AlexVolkov1987/UltiSteel_electronics/README.md

# UltiSteel_electronics
Electronics update for Ulti Steel 3D printer

------

:warning: Автор не несет ответственности за неправильную сборку, выбор комплектующих и любую порчу имущества и здоровья, вызванную эксплуатацией описываемых плат.
