AlexVolkov1987/UltiSteel_electronics/UlTi_head_connector/pdf/Connection to skr.pdf

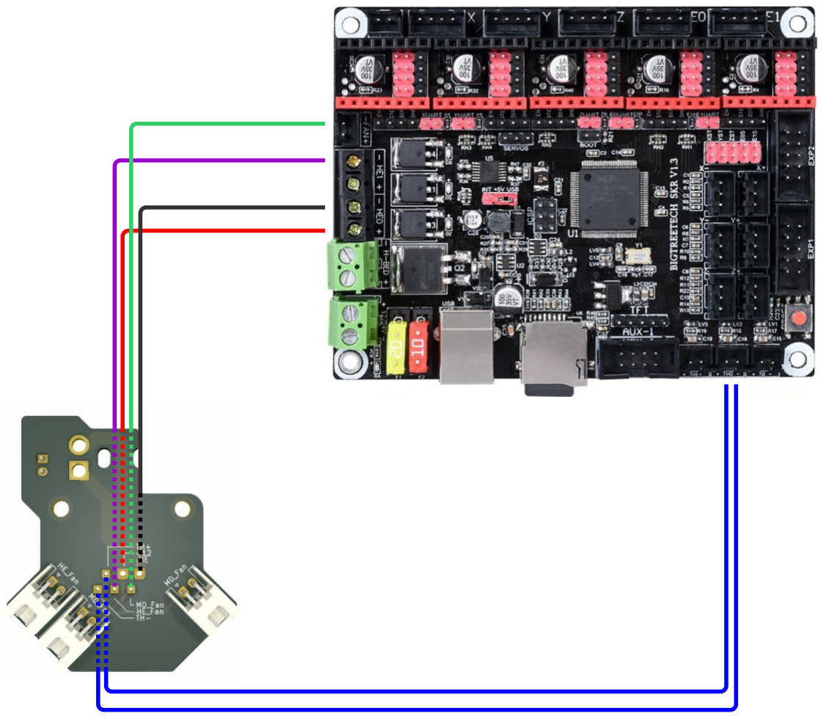
[picture p1: figure]

Провода +12 и HE 0.75мм (можно взять провода от нагревателя хотэнда)
Остальные провода сечением около 0.2мм

Все провода подключаются к плате головы со стороны разъемов хотэнда и термистора

С лицевой стороны платы:
HE_Fan на плате - разъем для кулера ХОТЭНДА
MD_Fan - разъемы для кулеров обдува МОДЕЛИ
В этих разъемах треугольник указывает на красный провод кулера.

С обратной стороны платы:
Heater - нагреватель
Thermistor - термистор

Термистор и нагреватель не имеют полярности и подключаются к пинам своих разъемов в любом порядке
