AlexVolkov1987/UltiSteel_electronics/UlTi_driver_ext_board/BOM.xlsx

REF | Value | Analog | Comment | Count
C1-C3 | 10uF 50V |  | Any 1206 smd ceramic 50V | 3
Q1-Q3 | IRLML6344 | PL4009 | TTL mosfet | 3
R1-R3 | 47 |  | 0603 smd res | 3
R4, R5 | 10k |  | 0603 smd res | 3
J1-J6 |  | PLS-40 | Split to 2 pieces (8 pins on each) | 1
XT2-XT4 | B2B-XH-A |  | JST-XH 2.5 series 2 pins | 3
