AlexVolkov1987/UltiSteel_electronics/UlTi_head_connector/BOM.xlsx

REF | Value | Analog | Comment | Count
Heater | AMASS XT30U-F |  |  | 1
HE_Fan, MD_Fan | JST XH S2B-XH-A |  |  | 3
Thermistor | JST XH B2B-XH-A |  |  | 1
