AlexVolkov1987/UltiSteel_electronics/UlTi_head_connector/isolator.dxf

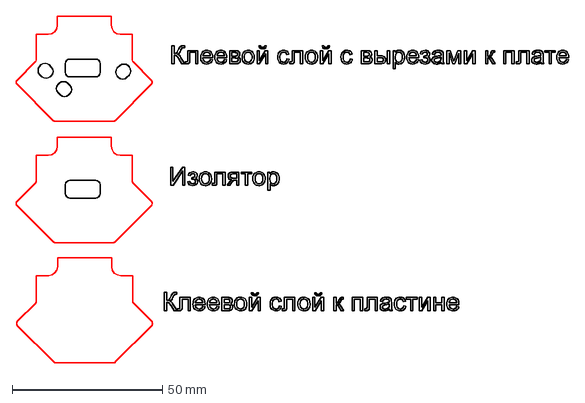
[picture p2: CAD file, 2021-06-25]
UlTi_head_connector/isolator.dxf
183.8 x 115.3 mm
