AlexVolkov1987/UltiSteel_electronics/UlTi_head_connector/прокладка.STL

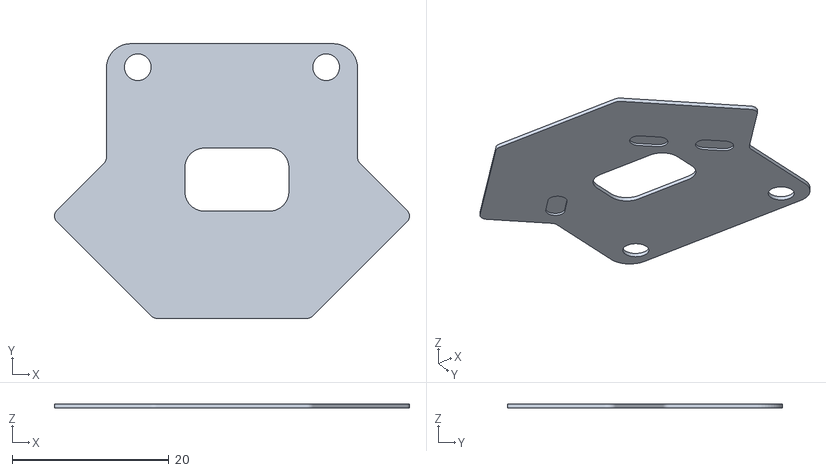
[picture p3: CAD file, 2021-06-25]
UlTi_head_connector/прокладка.STL
45.2 x 35.0 x 0.5
