AlexVolkov1987/UltiSteel_electronics/UlTi_head_connector/board.dxf

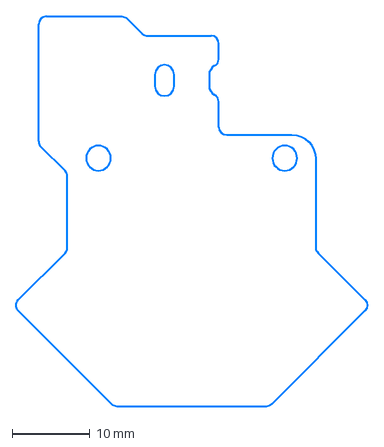
[picture p4: CAD file, 2021-01-16]
UlTi_head_connector/board.dxf
45.3 x 50.2 mm
