AlexVolkov1987/UltiSteel_electronics/Advanced_power_control/APC/PDF/TOP-assembly.pdf

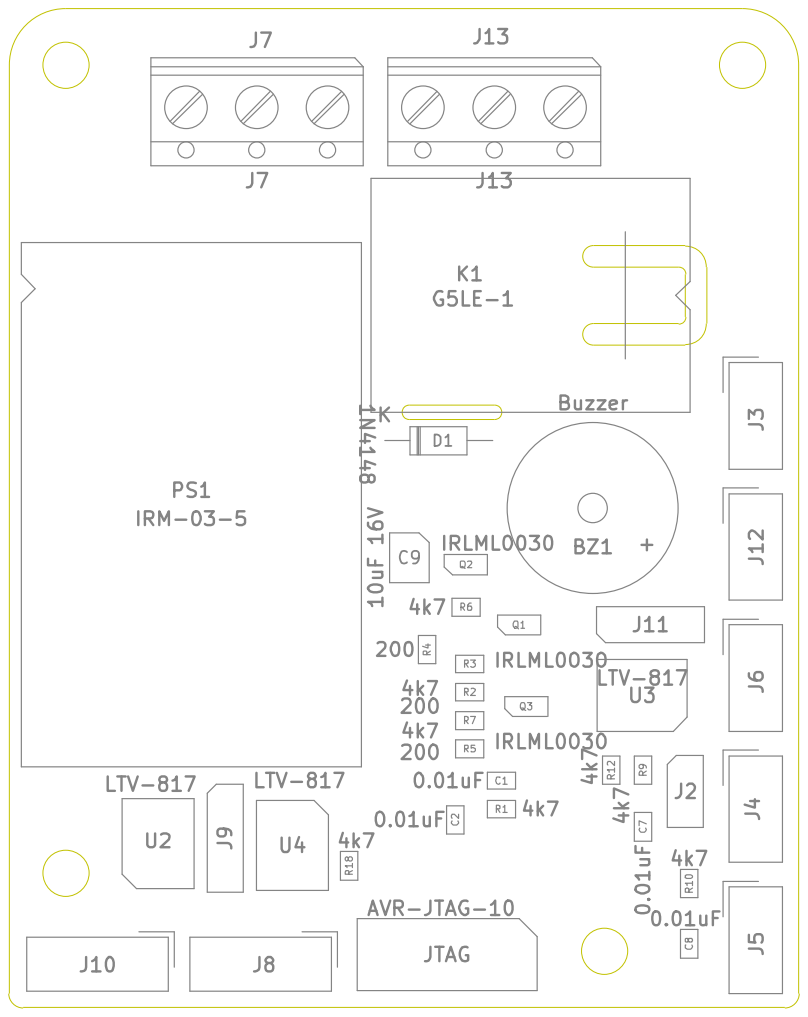
[picture p5: page 1]
