AlexVolkov1987/UltiSteel_electronics/Advanced_power_control/APC/PDF/BOTTOM-assembly.pdf

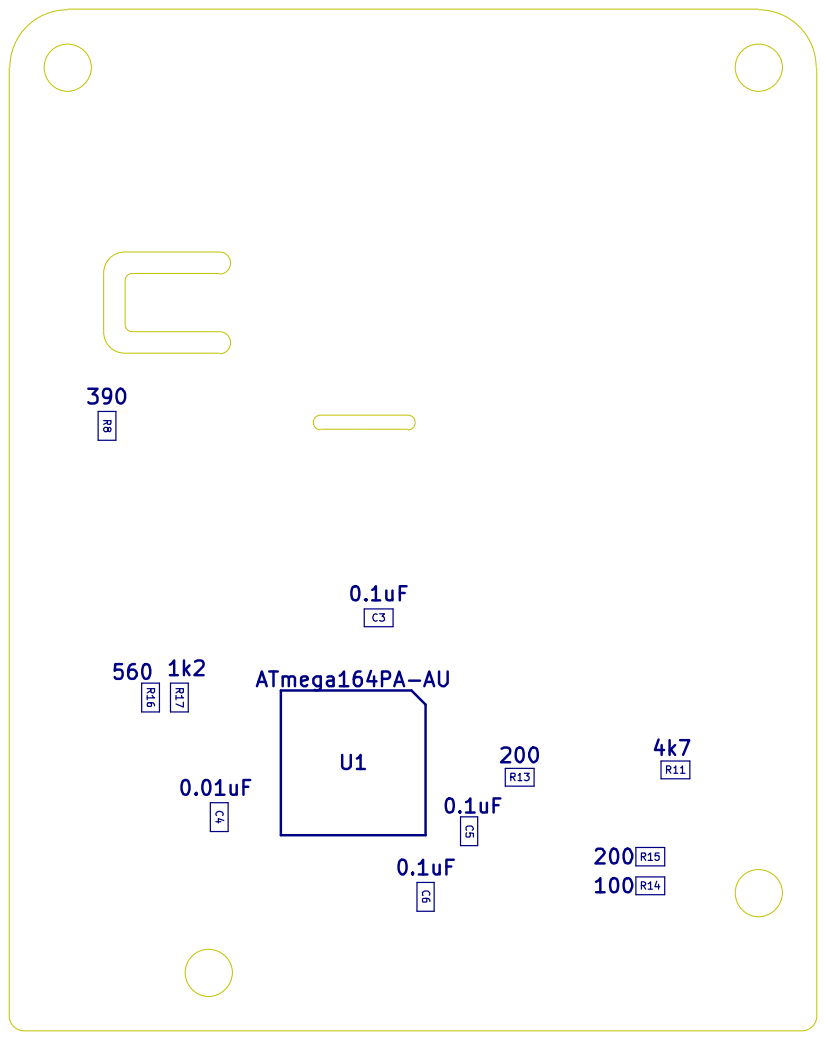
[picture p6: page 1]
