AlexVolkov1987/UltiSteel_electronics/UlTi_driver_ext_board/pdf/UlTi_driver_ext_board.pdf

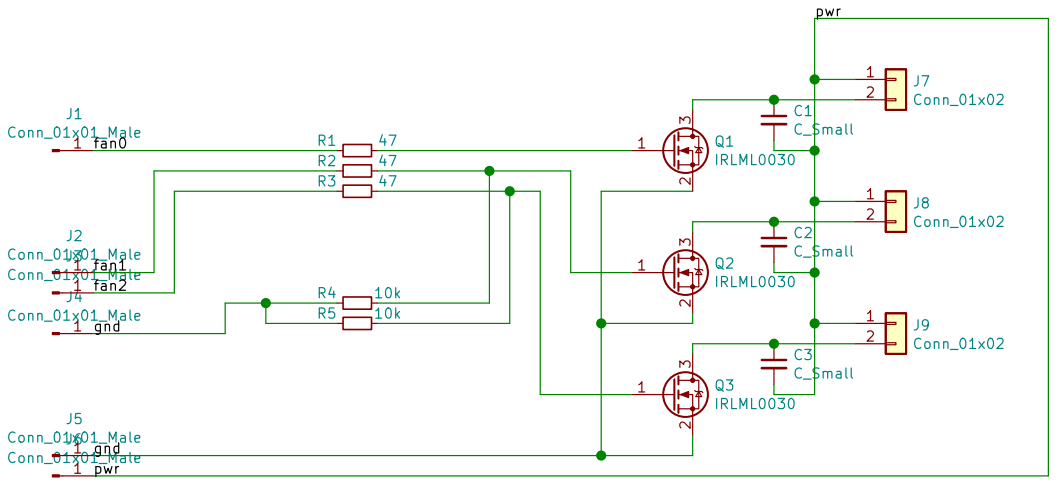
[picture p7: page 1]
