AlexVolkov1987/UltiSteel_electronics/UlTi_head_connector/pdf/UlTi_head_connector.pdf

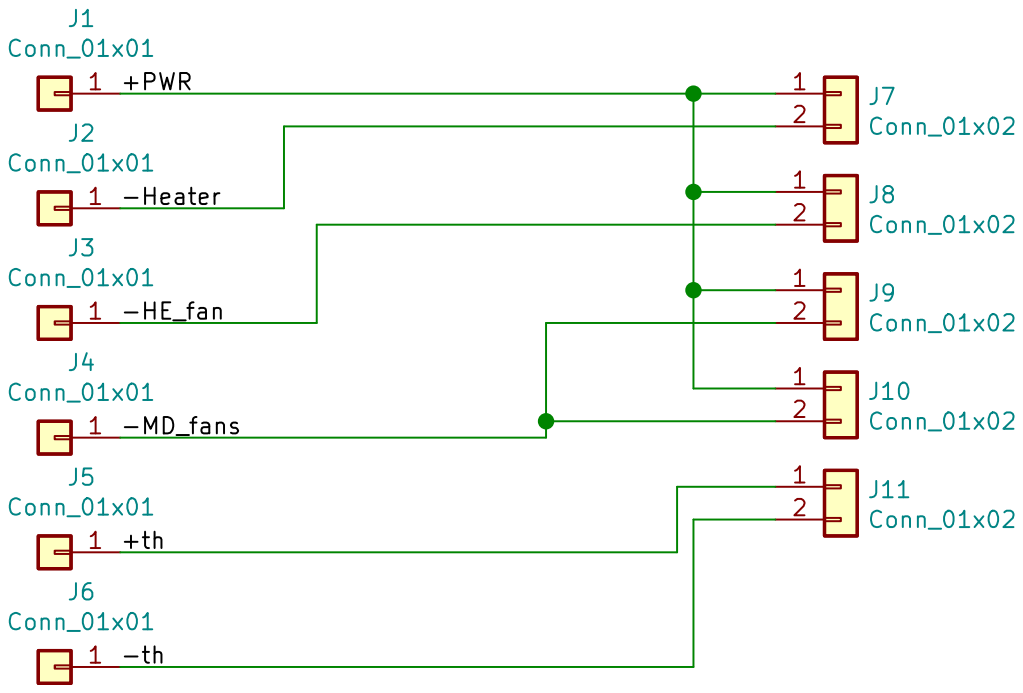
[picture p8: page 1]
