AlexVolkov1987/UltiSteel_electronics/Advanced_power_control/APC/APC.kicad_pcb

## KiCad design Advanced_power_control/APC/APC.kicad_pcb (2021-05-04)

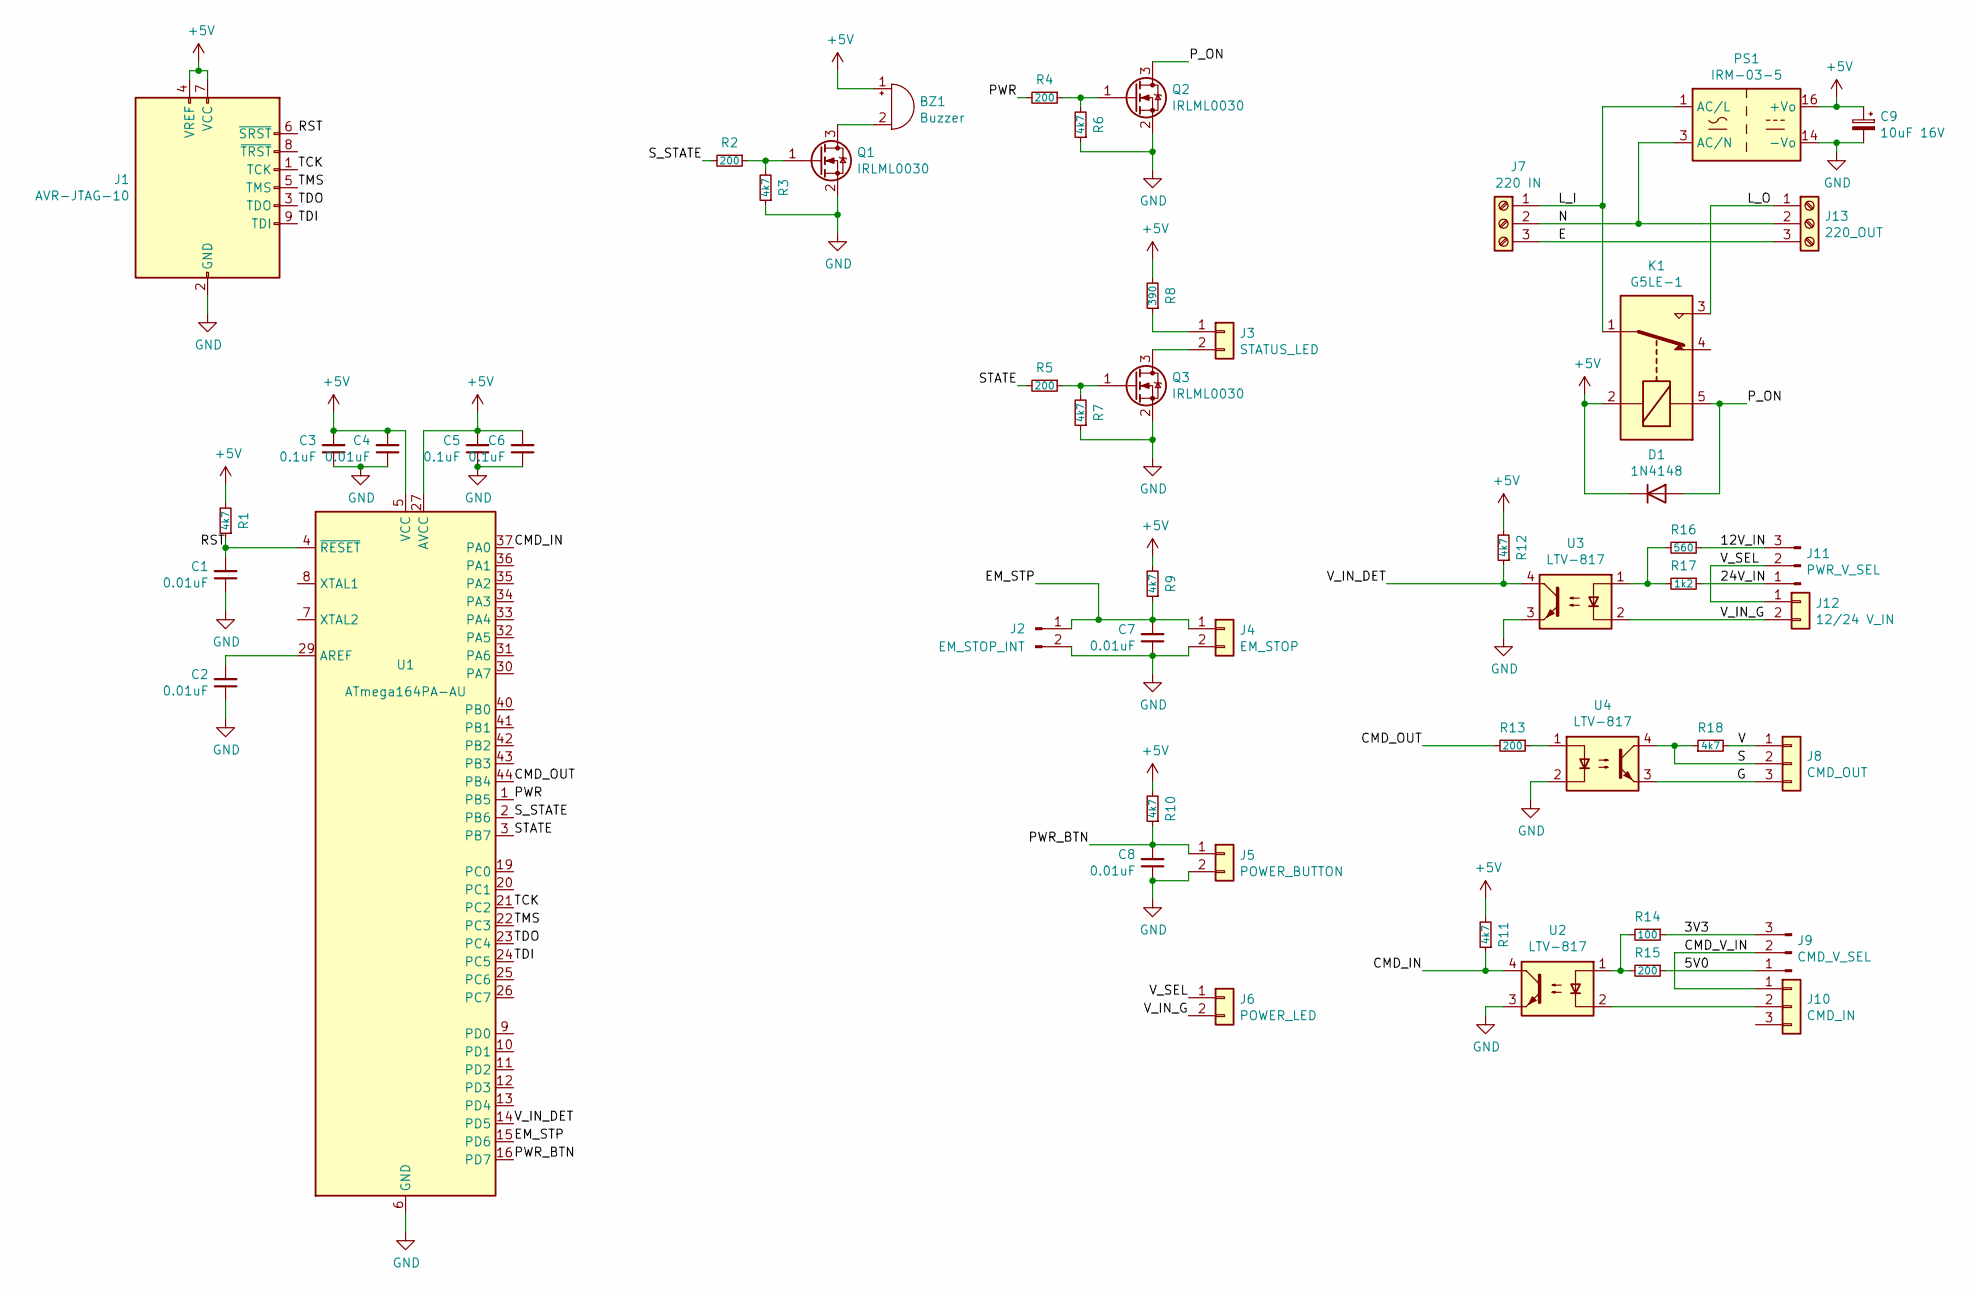
[picture p9: schematic APC.sch]

Parts:
BZ1: Buzzer; Buzzer_12x9.5RM7.6
C1, C2, C4, C7, C8: 0.01uF; C_0805_2012Metric_Pad1.15x1.40mm_HandSolder
C3, C5, C6: 0.1uF; C_0805_2012Metric_Pad1.15x1.40mm_HandSolder
C9: 10uF 16V; CP_EIA-3528-21_Kemet-B_Pad1.50x2.35mm_HandSolder
D1: 1N4148; D_DO-35_SOD27_P7.62mm_Horizontal
J1: AVR-JTAG-10; PinHeader_2x05_P2.54mm_Vertical
J2: EM_STOP_INT; PinHeader_1x02_P2.54mm_Vertical
J3: STATUS_LED; JST_EH_B2B-EH-A_1x02_P2.50mm_Vertical
J4: EM_STOP; JST_EH_B2B-EH-A_1x02_P2.50mm_Vertical
J5: POWER_BUTTON; JST_EH_B2B-EH-A_1x02_P2.50mm_Vertical
J6: POWER_LED; JST_EH_B2B-EH-A_1x02_P2.50mm_Vertical
J7: 220 IN; TerminalBlock_RND_205-00013_1x03_P5.00mm_Horizontal
J8: CMD_OUT; JST_EH_B3B-EH-A_1x03_P2.50mm_Vertical
J9: CMD_V_SEL; PinHeader_1x03_P2.54mm_Vertical
J10: CMD_IN; JST_EH_B3B-EH-A_1x03_P2.50mm_Vertical
J11: PWR_V_SEL; PinHeader_1x03_P2.54mm_Vertical
J12: 12/24 V_IN; JST_EH_B2B-EH-A_1x02_P2.50mm_Vertical
J13: 220_OUT; TerminalBlock_RND_205-00013_1x03_P5.00mm_Horizontal
K1: G5LE-1; Relay_SPDT_Omron-G5LE-1
PS1: IRM-03-5; Converter_ACDC_MeanWell_IRM-03-xx_THT
Q1, Q2, Q3: IRLML0030; SOT-23
R1, R3, R6, R7, R9, R10, R11, R12, R18: 4k7; R_0805_2012Metric_Pad1.20x1.40mm_HandSolder
R2, R4, R5, R13, R15: 200; R_0805_2012Metric_Pad1.20x1.40mm_HandSolder
R8: 390; R_0805_2012Metric_Pad1.20x1.40mm_HandSolder
R14: 100; R_0805_2012Metric_Pad1.20x1.40mm_HandSolder
R16: 560; R_0805_2012Metric_Pad1.20x1.40mm_HandSolder
R17: 1k2; R_0805_2012Metric_Pad1.20x1.40mm_HandSolder
U1: ATmega164PA-AU; TQFP-44_10x10mm_P0.8mm
U2, U3, U4: LTV-817; DIP-4_W7.62mm

Connections:
+5V: BZ1.1 (-), C3.2, C4.2, C5.2, C6.2, C9.1, D1.1 (K), J1.4 (VREF), J1.7 (VCC), K1.2, PS1.16 (+Vo), R1.2, R8.2, R9.2, R10.2, R11.2, R12.2, U1.5 (VCC), U1.17 (VCC), U1.27 (AVCC), U1.38 (VCC); also elsewhere on the board
/3V3: J9.3, R14.1
/5V0: J9.1, R15.1
/12V_IN: J11.3, R16.1
/24V_IN: J11.1, R17.1
/CMD_IN: R11.1, U1.37 (PA0), U2.4
/CMD_OUT: R13.2, U1.44 (PB4)
/CMD_V_IN: J9.2, J10.1
/E: J7.3, J13.3
/EM_STP: C7.2, J2.1, J4.1, R9.1, U1.15 (PD6)
/G: J8.3, U4.3
/L_I: J7.1, K1.1, PS1.1 (AC/L)
/L_O: J13.1, K1.3
/N: J7.2, J13.2, PS1.3 (AC/N)
/PWR: R4.2, U1.1 (PB5)
/PWR_BTN: C8.2, J5.1, R10.1, U1.16 (PD7)
/P_ON: D1.2 (A), K1.5, Q2.3 (D)
/RST: C1.2, J1.6 (~SRST), R1.1, U1.4 (~RESET); also elsewhere on the board
/S: J8.2, R18.1, U4.4
/STATE: R5.2, U1.3 (PB7)
/S_STATE: R2.2, U1.2 (PB6)
/TCK: J1.1 (TCK), U1.21 (PC2); also elsewhere on the board
/TDI: J1.9 (TDI), U1.24 (PC5); also elsewhere on the board
/TDO: J1.3 (TDO), U1.23 (PC4); also elsewhere on the board
/TMS: J1.5 (TMS), U1.22 (PC3); also elsewhere on the board
/V: J8.1, R18.2
/V_IN_DET: R12.1, U1.14 (PD5), U3.4
/V_IN_G: J6.2, J12.2, U3.2
/V_SEL: J6.1, J11.2, J12.1
GND: C1.1, C2.1, C3.1, C4.1, C5.1, C6.1, C7.1, C8.1, C9.2, J1.2 (GND), J1.10 (GND), J2.2, J4.2, J5.2, PS1.14 (-Vo), Q1.2 (S), Q2.2 (S), Q3.2 (S), R3.1, R6.1, R7.1, U1.6 (GND), U1.18 (GND), U1.28 (GND), U1.39 (GND), U2.3, U3.3, U4.2; also elsewhere on the board
unnamed: BZ1.2 (+), Q1.3 (D)
unnamed: C2.2, U1.29 (AREF)
unnamed: J3.1, R8.1
unnamed: J3.2, Q3.3 (D)
unnamed: J10.2, U2.2
unnamed: Q1.1 (G), R2.1, R3.2
unnamed: Q2.1 (G), R4.1, R6.2
unnamed: Q3.1 (G), R5.1, R7.2
unnamed: R13.1, U4.1
unnamed: R14.2, R15.2, U2.1
unnamed: R16.2, R17.2, U3.1

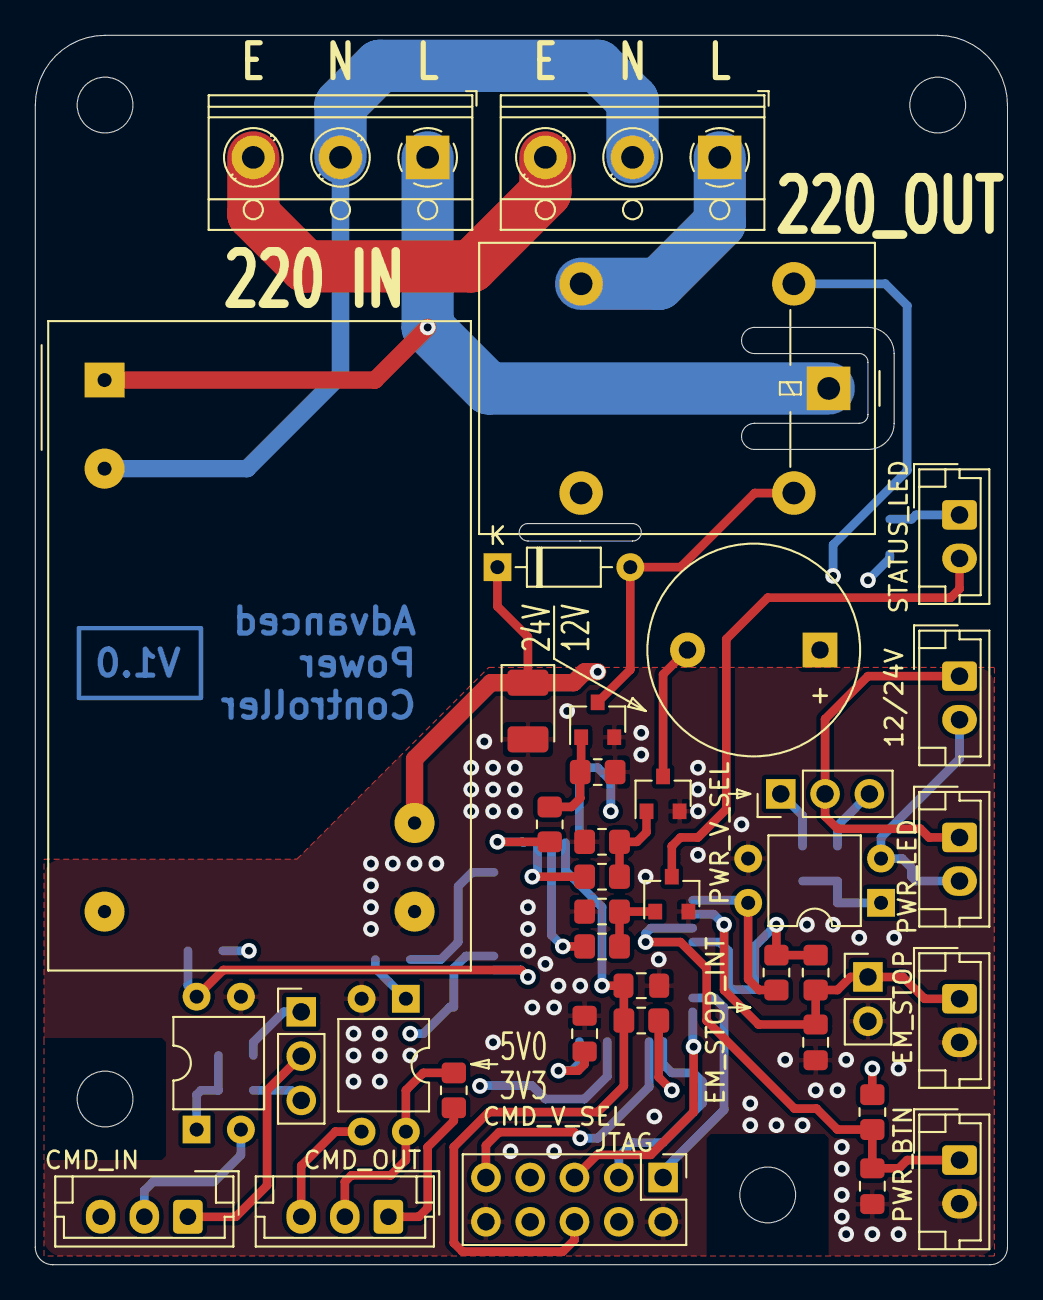
[picture p10: board APC.kicad_pcb from above]

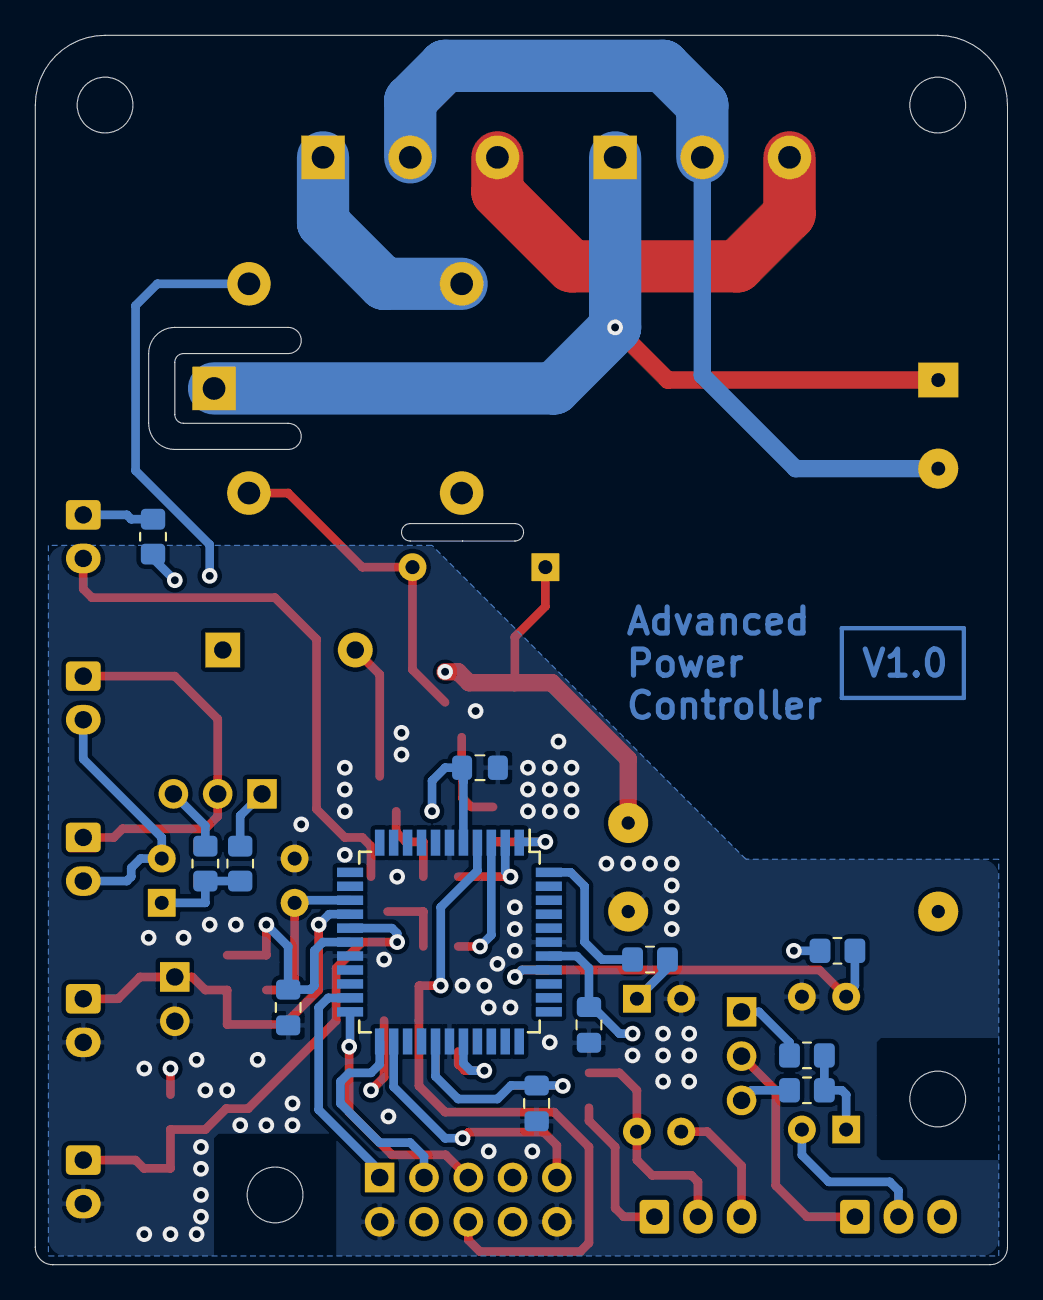
[picture p11: board APC.kicad_pcb from below]

Board: 4 copper layers, 55.8 x 70.5 mm, 51 parts (12 on the bottom side), 41 nets.

Other parts of the board:
JTAG: AVR-JTAG-10; PinHeader_2x05_P2.54mm_Vertical

Their connections:
+5V: JTAG.4, JTAG.7; also elsewhere on the board
/RST: JTAG.6; also elsewhere on the board
/TCK: JTAG.1; also elsewhere on the board
/TDI: JTAG.9; also elsewhere on the board
/TDO: JTAG.3; also elsewhere on the board
/TMS: JTAG.5; also elsewhere on the board
GND: JTAG.2, JTAG.10; also elsewhere on the board
