AlexVolkov1987/UltiSteel_electronics/Power_filter/Power_filter.kicad_pcb

## KiCad design Power_filter/Power_filter.kicad_pcb (2021-03-15)

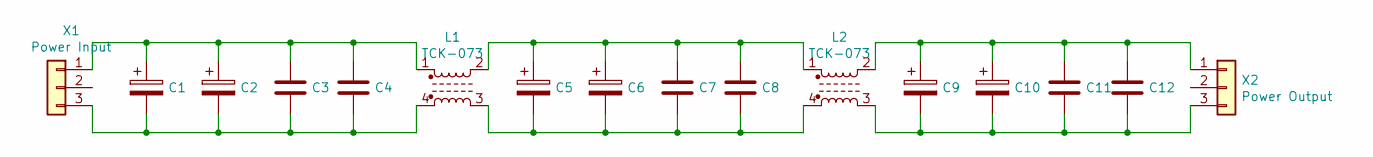
[picture p12: schematic Power_filter.sch]

Parts:
C1, C2, C5, C6, C9, C10: SH050M2200B7F-1636; CP_Radial_D16.0mm_P7.50mm
C3, C7, C11: RDER71H225K2K1H03B; C_Rect_L7.0mm_W3.5mm_P5.00mm
C4, C8, C12: RCER71H104K0M1H03A; C_Rect_L7.0mm_W2.5mm_P5.00mm
L1, L2: TCK-073; TRACO TCK-073
X1: Power Input; TerminalBlock_RND_205-00046_1x03_P5.00mm_Horizontal
X2: Power Output; TerminalBlock_RND_205-00046_1x03_P5.00mm_Horizontal

Connections:
unnamed: C1.1, C2.1, C3.1, C4.1, L1.1, X1.1
unnamed: C1.2, C2.2, C3.2, C4.2, L1.4, X1.3
unnamed: C5.1, C6.1, C7.1, C8.1, L1.2, L2.1
unnamed: C5.2, C6.2, C7.2, C8.2, L1.3, L2.4
unnamed: C9.1, C10.1, C11.1, C12.1, L2.2, X2.1
unnamed: C9.2, C10.2, C11.2, C12.2, L2.3, X2.3

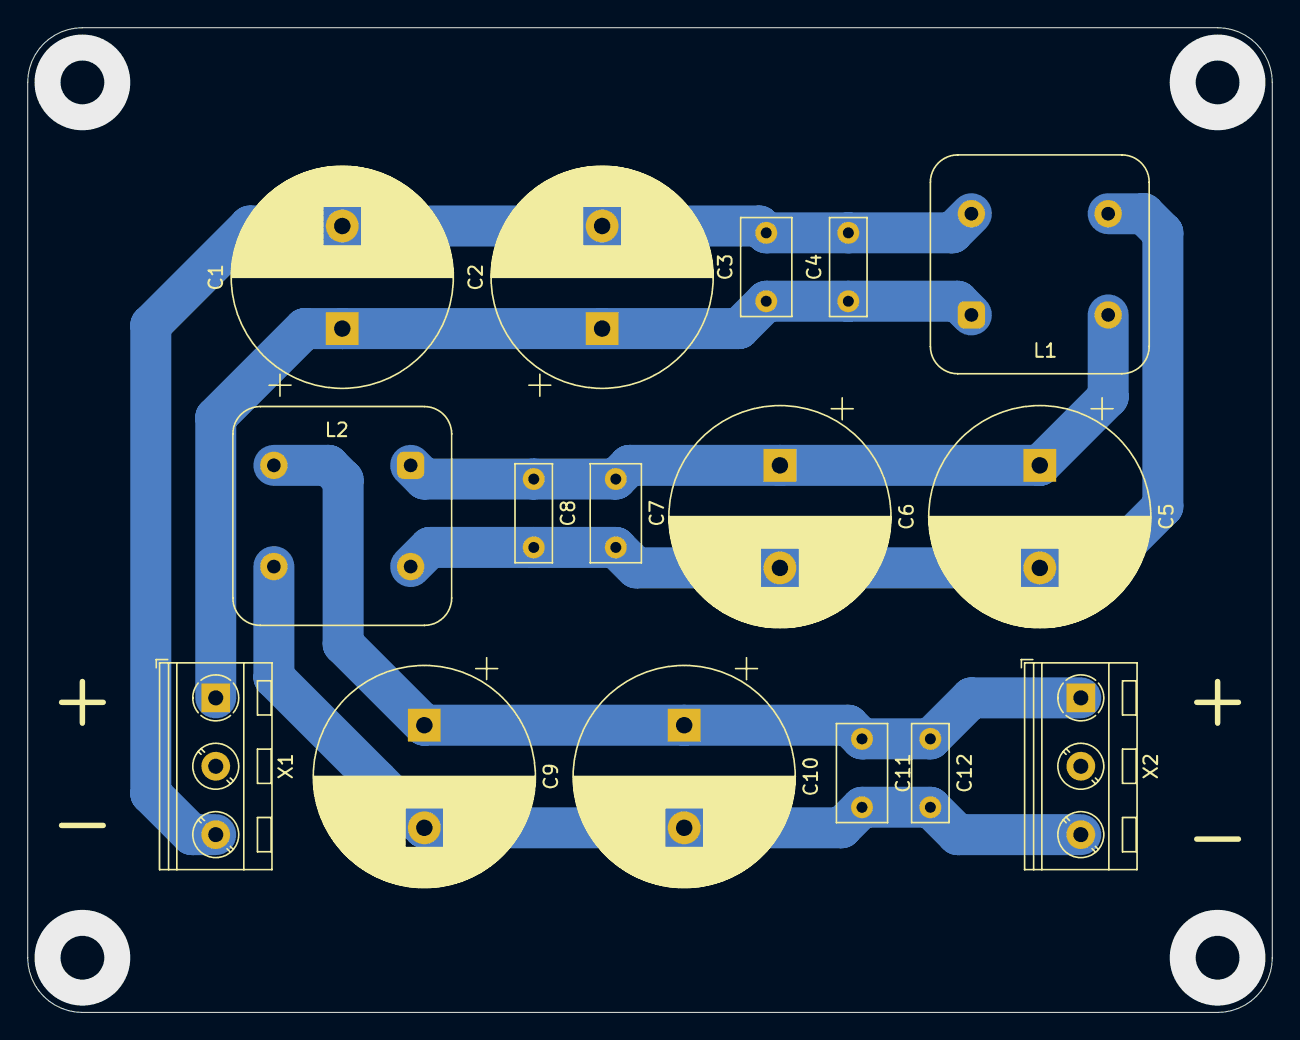
[picture p13: board Power_filter.kicad_pcb from above]

Board: 2 copper layers, 91.0 x 72.0 mm, 16 parts (0 on the bottom side), 6 nets.
