AlexVolkov1987/UltiSteel_electronics/UlTi_driver_ext_board/UlTi_driver_ext_board.kicad_pcb

## KiCad design UlTi_driver_ext_board/UlTi_driver_ext_board.kicad_pcb (2021-01-16)

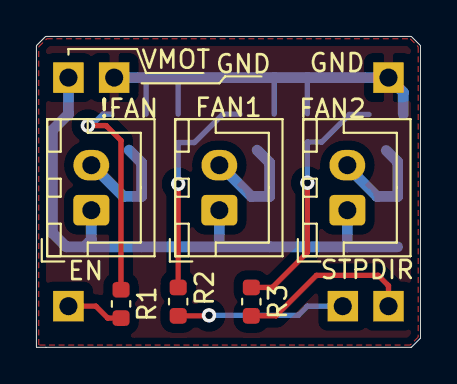
[picture p14: board UlTi_driver_ext_board.kicad_pcb from above]

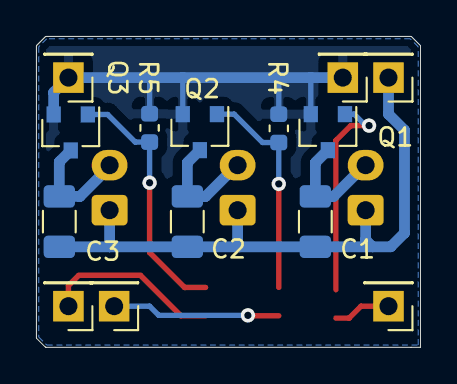
[picture p15: board UlTi_driver_ext_board.kicad_pcb from below]

Board: 2 copper layers, 21.3 x 17.3 mm, 20 parts (14 on the bottom side), 11 nets.

Parts:
!FAN: Conn_01x02; JST_XH_B2B-XH-A_1x02_P2.50mm_Vertical
C1, C2, C3: C_Small; C_1206_3216Metric
DIR: Conn_01x01_Male; PinHeader_1x01_P2.54mm_Vertical
EN: Conn_01x01_Male; PinHeader_1x01_P2.54mm_Vertical
FAN1, FAN2: Conn_01x02; JST_XH_B2B-XH-A_1x02_P2.50mm_Vertical
GND: Conn_01x01_Male; PinHeader_1x01_P2.54mm_Vertical
GND#2: Conn_01x01_Male; PinHeader_1x01_P2.54mm_Vertical
Q1, Q2, Q3: IRLML0030; SOT-23
R1, R2, R3: 47; R_0603_1608Metric
R4, R5: 10k; R_0603_1608Metric
STP: Conn_01x01_Male; PinHeader_1x01_P2.54mm_Vertical
VMOT: Conn_01x01_Male; PinHeader_1x01_P2.54mm_Vertical

Connections:
/fan0: EN.1, R1.2
/fan1: R2.2, STP.1
/fan2: DIR.1, R3.2
/gnd: GND.1, GND#2.1, Q1.2, Q2.2, Q3.2, R4.2, R5.2
/pwr: !FAN.1, C1.2, C2.2, C3.2, FAN1.1, FAN2.1, VMOT.1
unnamed: !FAN.2, C1.1, Q1.3
unnamed: C2.1, FAN1.2, Q2.3
unnamed: C3.1, FAN2.2, Q3.3
unnamed: Q1.1, R1.1
unnamed: Q2.1, R2.1, R4.1
unnamed: Q3.1, R3.1, R5.1
