AlexVolkov1987/UltiSteel_electronics/UlTi_head_connector/UlTi_head_connector.kicad_pcb

## KiCad design UlTi_head_connector/UlTi_head_connector.kicad_pcb (2021-01-16)

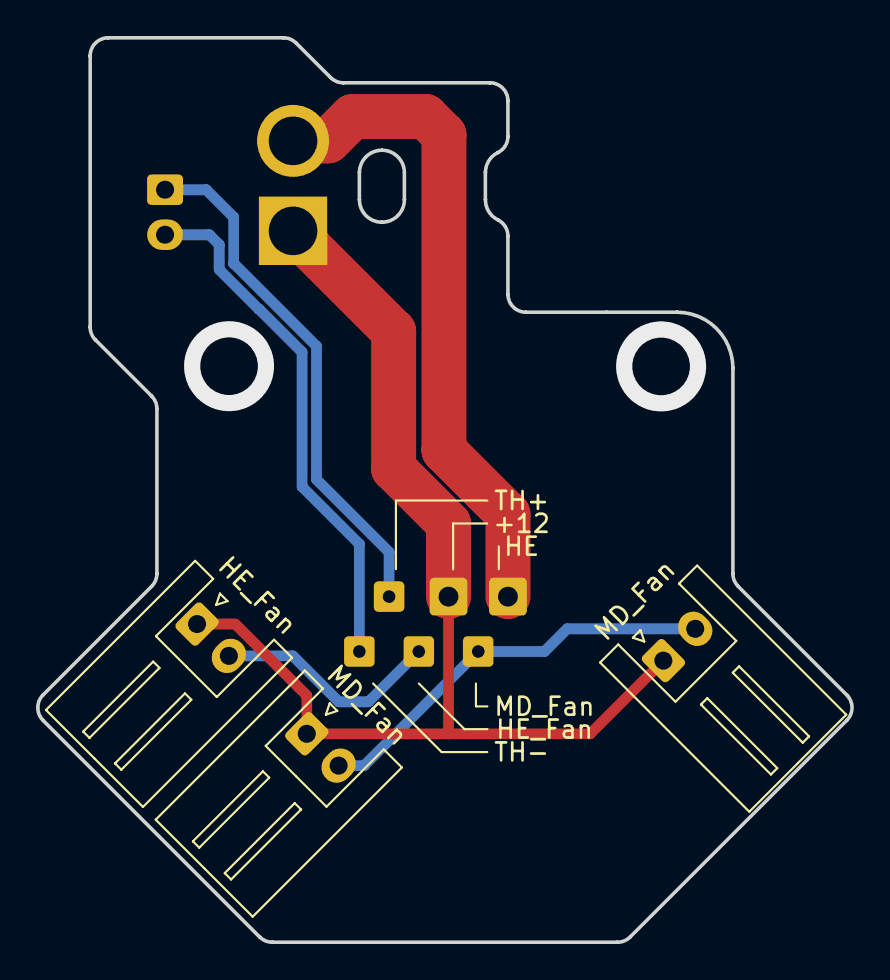
[picture p16: board UlTi_head_connector.kicad_pcb from above]

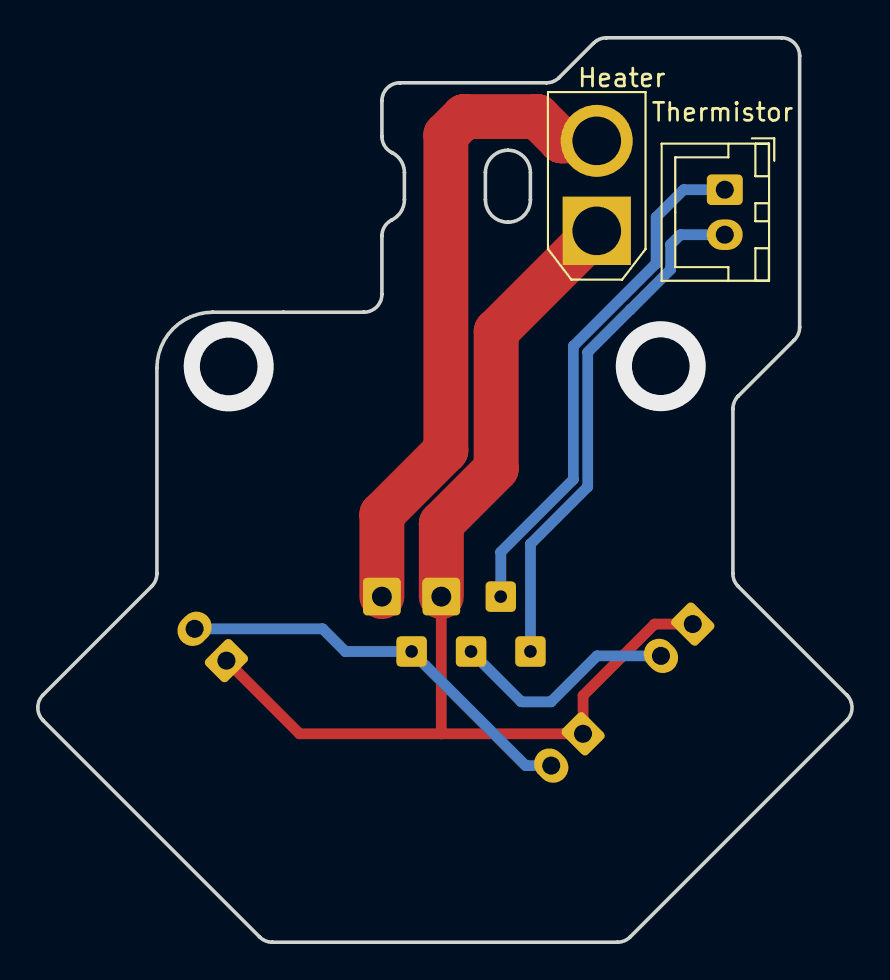
[picture p17: board UlTi_head_connector.kicad_pcb from below]

Board: 2 copper layers, 45.2 x 50.2 mm, 11 parts (2 on the bottom side), 6 nets.

Parts:
+12: Conn_01x01; SolderWire-0.5sqmm_1x01_D0.9mm_OD2.1mm
HE: Conn_01x01; SolderWire-0.5sqmm_1x01_D0.9mm_OD2.1mm
HE_Fan: Conn_01x02; JST_XH_S2B-XH-A_1x02_P2.50mm_Horizontal
HE_Fan#2: Conn_01x01; SolderWire-0.15sqmm_1x01_D0.5mm_OD1.5mm
Heater: Conn_01x02; AMASS_XT30U-F_1x02_P5.0mm_Vertical
MD_Fan: Conn_01x02; JST_XH_S2B-XH-A_1x02_P2.50mm_Horizontal
MD_Fan#2: Conn_01x02; JST_XH_S2B-XH-A_1x02_P2.50mm_Horizontal
MD_Fan#3: Conn_01x01; SolderWire-0.15sqmm_1x01_D0.5mm_OD1.5mm
TH+: Conn_01x01; SolderWire-0.15sqmm_1x01_D0.5mm_OD1.5mm
TH-: Conn_01x01; SolderWire-0.15sqmm_1x01_D0.5mm_OD1.5mm
Thermistor: Conn_01x02; JST_XH_B2B-XH-A_1x02_P2.50mm_Vertical

Connections:
/+PWR: +12.1, HE_Fan.1, Heater.1, MD_Fan.1, MD_Fan#2.1
/+th: TH+.1, Thermistor.1
/-HE_fan: HE_Fan.2, HE_Fan#2.1
/-Heater: HE.1, Heater.2
/-MD_fans: MD_Fan.2, MD_Fan#2.2, MD_Fan#3.1
/-th: TH-.1, Thermistor.2
