AlexVolkov1987/UltiSteel_electronics/(commit log)

2021-01-16 Initial Commit
    Добавлены все файлы проектов платы расширения и платы головы
    [BOM.xlsx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]
2021-03-15 add test power_filter
    [Power_filter.kicad_pcb, Power_filter.sch]
2021-03-17 add gerbers
    [Power_filter-B_Cu.gbr, Power_filter-B_Mask.gbr, Power_filter-B_SilkS.gbr, Power_filter-Edge_Cuts.gbr, Power_filter-F_Cu.gbr, Power_filter-F_Mask.gbr, Power_filter-F_SilkS.gbr, Power_filter-NPTH.drl]
2021-04-27 add APC
    [APC.kicad_pcb, APC.sch]
2021-04-28 init schematic
    [APC.sch]
2021-04-28 update schematic
    [APC.sch]
2021-04-28 add some schematic features
    [APC.sch]
2021-04-29 pcb routing
    [APC.kicad_pcb, APC.sch]
2021-04-29 update schematic and board
    [APC.kicad_pcb, APC.sch]
2021-04-30 minimize pcb size
    [APC.kicad_pcb, APC.sch]
2021-05-04 Update APC.kicad_pcb
    PreFinal correction
    [APC.kicad_pcb]
2021-05-04 Release 1.0
    Update pcb
    Add assembly pdf-files
    Add gerber files
    [APC-B_Cu.gbl, APC-B_Mask.gbs, APC-B_Paste.gbp, APC-B_SilkS.gbo, APC-Edge_Cuts.gm1, APC-F_Cu.gtl, APC-F_Mask.gts, APC-F_Paste.gtp]
2021-05-04 some changes
    Change vias size fo jlcpcb
    Add gerbers in zip archive
    [APC-B_Cu.gbl, APC-B_Mask.gbs, APC-B_Paste.gbp, APC-B_SilkS.gbo, APC-Edge_Cuts.gm1, APC-F_Cu.gtl, APC-F_Mask.gts, APC-F_Paste.gtp]
2021-05-26 PDF correction
    Corrected values position on assembly
    Add BOM
2021-05-28 major changes
    - split readme.md
    -add isolator.dxf
    [isolator.dxf]
